baoqt/Bluetooth_IMU/PCB files/CAMOutputs_2_0/BOM.xls

10sets |  | PCBWay Comments | Your Reply | Item # | Designator | QTY | Manufacturer | MFG Part # | Description / Value | Package / Footprint | Type |  |  |  | Instructions / Notes
$0.420 | $8.40 | updated EVQ-Q2B03W |  | 1 | B1, B2 | 2 | C&K | EVQ-Q2B03W |  |  | SMT
$0.105 | $1.05 |  |  | 2 | C1 | 1 | Murata Electronics | GRM188R71C474MA88D | 0.47u | C0402 | SMT
$0.053 | $1.58 |  |  | 3 | C2, C5, C6 | 3 | Samsung Electro-Mechanics | CL05B104KO5NNNC | 0.1u | C0402 | SMT
$0.420 | $4.20 | 7-10work days |  | 4 | C3 | 1 | Taiyo Yuden | HMK105B7103KVHFE | 10n | C0402 | SMT
$0.210 | $2.10 |  |  | 5 | C4 | 1 | Samsung Electro-Mechanics | CL31B225KBHNNNE | 2.2n | C1206 | SMT
$0.105 | $4.20 |  |  | 6 | C7, C8, C9, C10 | 4 | Samsung Electro-Mechanics | CL21A475KAQNNNE | 4.7u | C0805 | SMT
$0.105 | $4.20 |  |  | 7 | C11, C12, C14, C15 | 4 | Samsung Electro-Mechanics | CL05A105KA5NQNC | 1u | C0402 | SMT
$0.840 | $8.40 | updated digikey2500pcs 7-10work days |  | 8 | C13 | 1 | Vishay | 593D107X9010C2TE3 | 100u | C2312 | SMT
$0.105 | $1.05 |  |  | 9 | LED1 | 1 | Lite-On Inc. | LTST-C190KRKT | Red | SML0603 | SMT
$0.105 | $1.05 | LTST-C190KGKT |  | 10 | LED2 | 1 | Lite-On Inc. | LTST-C190KGKT | Green | SML0603 | SMT
$0.105 | $1.05 | LTST-C190TBKT |  | 11 | LED3 | 1 | Lite-On Inc. | LTST-C190TBKT | Blue | SML0603 | SMT
$0.032 | $0.63 |  |  | 12 | R1, R2 | 2 | Panasonic Electronic Components | ERJ-3EKF5111V | 5.11k | R0603 | SMT
$0.032 | $0.63 | no stock, suggest RC0603FR-071KL | Substitution acceptable | 13 | R3, R4 | 2 | Vishay | MCT0603MD1001DP500 | 1k | R0603 | SMT
$0.032 | $0.32 |  |  | 14 | R5 | 1 | Vishay | CRCW060322K1FKEA | 22.1k | R0603 | SMT
$0.032 | $0.32 |  |  | 15 | R6 | 1 | Vishay | CRCW040247K5FKED | 47.5k | R0402 | SMT
$0.032 | $0.32 |  |  | 16 | R7 | 1 | Vishay | CRCW0402100RFKTD | 100 | R0402 | SMT
$0.032 | $1.26 |  |  | 17 | R8, R9, R12, R15 | 4 | Vishay | CRCW040210K0JNEDIF | 10k | R0402 | SMT
$0.032 | $0.32 |  |  | 18 | R10 | 1 | Vishay | CRCW040275K0JNED | 75k | R0402 | SMT
$0.472 | $14.18 | 7-10work days |  | 19 | R16, R19, R20 | 3 | Vishay | MCT0603MC1003FP500 | 100k | R0603 | SMT
$0.032 | $0.95 |  |  | 20 | R11, R13, R14 | 3 | Vishay | CRCW0402470RJNED | 470 | R0402 | SMT
$0.105 | $1.05 | no stock, suggest RC1206FR-074M99L 4.99M please confirm | Substitution acceptable | 21 | R17 | 1 | Susumu | RG3216P-5004-B-T1 | 5M | R0805 | SMT
$6.090 | $60.90 |  |  | 23 | U1 | 1 | TDK InvenSense | ICM-20689 |  | 24-QFN(4X4) | SMT | MEMS sensor, shock sensitive
$6.825 | $68.25 |  |  | 24 | U2 | 1 | Espressif Systems | ESP32-WROOM-32D (16MB) |  |  | SMT
$5.250 | $52.50 |  |  | 25 | U3 | 1 | Silicon Labs | CP2102N-A02-GQFN28R |  | 28-QFN(5X5) | SMT
$0.420 | $4.20 | updated mouser 167pcs 7-10work days |  | 26 | U4 | 1 | Rohm Semiconductor | UMH3NFHATN |  | UMT6 | SMT
$0.945 | $9.45 |  |  | 27 | U5 | 1 | Microchip Technology | MCP73831T-2ATI/OT |  | SOT-23-5 | SMT
$0.840 | $8.40 | updated in stock |  | 28 | U6 | 1 | Diodes Incorporated | AP7331-SNG-7 |  | U-DFN2020-6 | SMT
$0.945 | $9.45 |  |  | 29 | U7 | 1 | JST Sales America Inc. | S2B-PH-SM4-TB(LF)(SN) |  | S2B-PH-SM4-TB(LF)(SN) | SMT
$0.630 | $6.30 |  |  | 30 | U8 | 1 | Littelfuse Inc. | SP0503BAHTG |  | SOT-143-4 | SMT
$1.260 | $12.60 | 7-10work days |  | 31 | U9 | 1 | Molex | 2137160001 |  |  | THT
$0.420 | $4.20 | TC7WZ00FK,LJ(CT 7-10work days, pad design is larger than component，please provide with correct part number | Pad updated in new gerber files. | 32 | U10 | 1 | Toshiba Semiconductor and Storage | TC7WZ00FK |  | US8_TOS | SMT
 | $293.475 |  |  |  | Total Components | 49
quote to MFG Part #
 |  |  | Digikey Part Number | Type | Value | SMT | Cost |  | Signifier | Manufacturer Part Number | Digikey Part Number | Type | Value | SMT
 |  |  | P12932SCT-ND | Button |  | Yes | 0.28 |  | B1 | EVQ-Q2B03W | P12932SCT-ND | Button |  | Yes
 |  |  | 490-GRM188R71C474MA88DDKR-ND | Capacitor | 0.47u | Yes | 0.15 |  | B2 | EVQ-Q2B03W | P12932SCT-ND | Button |  | Yes
 |  |  | 1276-1001-1-ND | Capacitor | 0.1u | Yes | 0.10 |  | C1 | GRM188R71C474MA88D | 490-GRM188R71C474MA88DDKR-ND | Capacitor | 0.47u | Yes
 |  |  | 587-HMK105B7103KVHFECT-ND | Capacitor | 10n | Yes | 0.20 |  | C2 | CL05B104KO5NNNC | 1276-1001-1-ND | Capacitor | 0.1u | Yes
 |  |  | 1276-1291-1-ND | Capacitor | 2.2n | Yes | 0.26 |  | C3 | HMK105B7103KVHFE | 587-HMK105B7103KVHFECT-ND | Capacitor | 10n | Yes
 |  |  | 1276-1244-1-ND | Capacitor | 4.7u | Yes | 0.11 |  | C4 | CL31B225KBHNNNE | 1276-1291-1-ND | Capacitor | 2.2n | Yes
 |  |  | 1276-1445-1-ND | Capacitor | 1u | Yes | 0.20 |  | C5 | CL05B104KO5NNNC | 1276-1001-1-ND | Capacitor | 0.1u | Yes
 |  |  | 718-1971-6-ND | Capacitor | 100u | Yes | 0.80 |  | C6 | CL05B104KO5NNNC | 1276-1001-1-ND | Capacitor | 0.1u | Yes
 |  |  | 160-1436-1-ND | LED | Red | Yes | 0.25 |  | C7 | CL21A475KAQNNNE | 1276-1244-1-ND | Capacitor | 4.7u | Yes
 |  |  | 160-1435-1-ND | LED | Green | Yes | 0.31 |  | C8 | CL21A475KAQNNNE | 1276-1244-1-ND | Capacitor | 4.7u | Yes
 |  |  | 160-1646-1-ND | LED | Blue | Yes | 0.26 |  | C9 | CL21A475KAQNNNE | 1276-1244-1-ND | Capacitor | 4.7u | Yes
 |  |  | P5.11KHCT-ND | Resistor | 5.11k | Yes | 0.10 |  | C10 | CL21A475KAQNNNE | 1276-1244-1-ND | Capacitor | 4.7u | Yes
 |  |  | MCT0603-1.0K-MDDKR-ND | Resistor | 1k | Yes | 0.36 |  | C11 | CL05A105KA5NQNC | 1276-1445-1-ND | Capacitor | 1u | Yes
 |  |  | 541-22.1KHDKR-ND | Resistor | 22.1k | Yes | 0.10 |  | C12 | CL05A105KA5NQNC | 1276-1445-1-ND | Capacitor | 1u | Yes
 |  |  | 541-47.5KLCT-ND | Resistor | 47.5k | Yes | 0.10 |  | C13 | 593D107X9010C2TE3 | 718-1971-6-ND | Capacitor | 100u | Yes
 |  |  | 541-CRCW0402100RFKTDDKR-ND | Resistor | 100 | Yes | 0.13 |  | C14 | CL05A105KA5NQNC | 1276-1445-1-ND | Capacitor | 1u | Yes
 |  |  | 541-10KATDKR-ND | Resistor | 10k | Yes | 0.40 |  | C15 | CL05A105KA5NQNC | 1276-1445-1-ND | Capacitor | 1u | Yes
 |  |  | 541-75KJDKR-ND | Resistor | 75k | Yes | 0.10 |  | LED1 | LTST-C190KRKT | 160-1436-1-ND | LED | Red | Yes
 |  |  | MCT0603-100K-MFCT-ND | Resistor | 100k | Yes | 0.31 |  | LED2 | LTST-C190KGKT | 160-1435-1-ND | LED | Green | Yes
 |  |  | 541-470JDKR-ND | Resistor | 470 | Yes | 0.10 |  | LED3 | LTST-C190TBKT | 160-1646-1-ND | LED | Blue | Yes
 |  |  | 408-2038-1-ND | Resistor | 5M | Yes | 1.96 |  | R1 | ERJ-3EKF5111V | P5.11KHCT-ND | Resistor | 5.11k | Yes
 |  |  | 1428-1059-1-ND | IC |  | Yes | 6.36 |  | R2 | ERJ-3EKF5111V | P5.11KHCT-ND | Resistor | 5.11k | Yes
 |  |  | 1904-1025-6-ND | Module |  | Yes | 4.50 |  | R3 | MCT0603MD1001DP500 | MCT0603-1.0K-MDDKR-ND | Resistor | 1k | Yes
 |  |  | 336-5890-1-ND | IC |  | Yes | 1.40 |  | R4 | MCT0603MD1001DP500 | MCT0603-1.0K-MDDKR-ND | Resistor | 1k | Yes
 |  |  | UMH3NFHATNCT-ND | IC |  | Yes | 0.38 |  | R5 | CRCW060322K1FKEA | 541-22.1KHDKR-ND | Resistor | 22.1k | Yes
 |  |  | MCP73831T-2ATI/OTCT-ND | IC |  | Yes | 0.59 |  | R6 | CRCW040247K5FKED | 541-47.5KLCT-ND | Resistor | 47.5k | Yes
 |  |  | AP7331-SNG-7DICT-ND | IC |  | Yes | 0.46 |  | R7 | CRCW0402100RFKTD | 541-CRCW0402100RFKTDDKR-ND | Resistor | 100 | Yes
 |  |  | 455-1749-1-ND | Connector |  | Yes | 0.53 |  | R8 | CRCW040210K0JNEDIF | 541-10KATDKR-ND | Resistor | 10k | Yes
 |  |  | F2715DKR-ND | IC |  | Yes | 0.89 |  | R9 | CRCW040210K0JNEDIF | 541-10KATDKR-ND | Resistor | 10k | Yes
 |  |  | 900-2137160001CT-ND | Connector |  | No | 1.12 |  | R10 | CRCW040275K0JNED | 541-75KJDKR-ND | Resistor | 75k | Yes
 |  |  | TC7WZ00FKLJ(CTCT-ND | IC |  | Yes | 0.40 |  | R11 | CRCW0402470RJNED | 541-470JDKR-ND | Resistor | 470 | Yes
 |  |  |  |  |  |  | #REF! |  | R12 | CRCW040210K0JNEDIF | 541-10KATDKR-ND | Resistor | 10k | Yes
 |  |  |  |  |  |  |  |  | R13 | CRCW0402470RJNED | 541-470JDKR-ND | Resistor | 470 | Yes
 |  |  |  |  |  |  |  |  | R14 | CRCW0402470RJNED | 541-470JDKR-ND | Resistor | 470 | Yes
 |  |  |  |  |  |  |  |  | R15 | CRCW040210K0JNEDIF | 541-10KATDKR-ND | Resistor | 10k | Yes
 |  |  |  |  |  |  |  |  | R16 | MCT0603MC1003FP500 | MCT0603-100K-MFCT-ND | Resistor | 100k | Yes
 |  |  |  |  |  |  |  |  | R17 | HVC0805T5004JET | HVC0805T5004JETCT-ND | Resistor | 5M | Yes
 |  |  |  |  |  |  |  |  | R19 | MCT0603MC1003FP500 | MCT0603-100K-MFCT-ND | Resistor | 100k | Yes
 |  |  |  |  |  |  |  |  | R20 | MCT0603MC1003FP500 | MCT0603-100K-MFCT-ND | Resistor | 100k | Yes
 |  |  |  |  |  |  |  |  | U1 | ICM-20689 | 1428-1059-1-ND | IC |  | Yes
 |  |  |  |  |  |  |  |  | U2 | ESP32-WROOM-32D (16MB) | 1904-1025-6-ND | Module |  | Yes
 |  |  |  |  |  |  |  |  | U3 | CP2102N-A02-GQFN28R | 336-5890-1-ND | IC |  | Yes
 |  |  |  |  |  |  |  |  | U4 | UMH3NFHATN | UMH3NFHATNCT-ND | IC |  | Yes
 |  |  |  |  |  |  |  |  | U5 | MCP73831T-2ATI/OT | MCP73831T-2ATI/OTCT-ND | IC |  | Yes
 |  |  |  |  |  |  |  |  | U6 | AP7331-SNG-7 | AP7331-SNG-7DICT-ND | IC |  | Yes
 |  |  |  |  |  |  |  |  | U7 | S2B-PH-SM4-TB(LF)(SN) | 455-1749-1-ND | Connector |  | Yes
 |  |  |  |  |  |  |  |  | U8 | SP0503BAHTG | F2715DKR-ND | IC |  | Yes
 |  |  |  |  |  |  |  |  | U9 | 2137160001 | 900-2137160001CT-ND | Connector |  | No
 |  |  |  |  |  |  |  |  | U10 | TC7WZ00FK | TC7WZ00FKLJ(CTCT-ND | IC |  | Yes
