baoqt/Bluetooth_IMU/PCB files/BT_IMU_2_0.brd

## EAGLE design PCB files/BT_IMU_2_0.brd (2021-10-09)

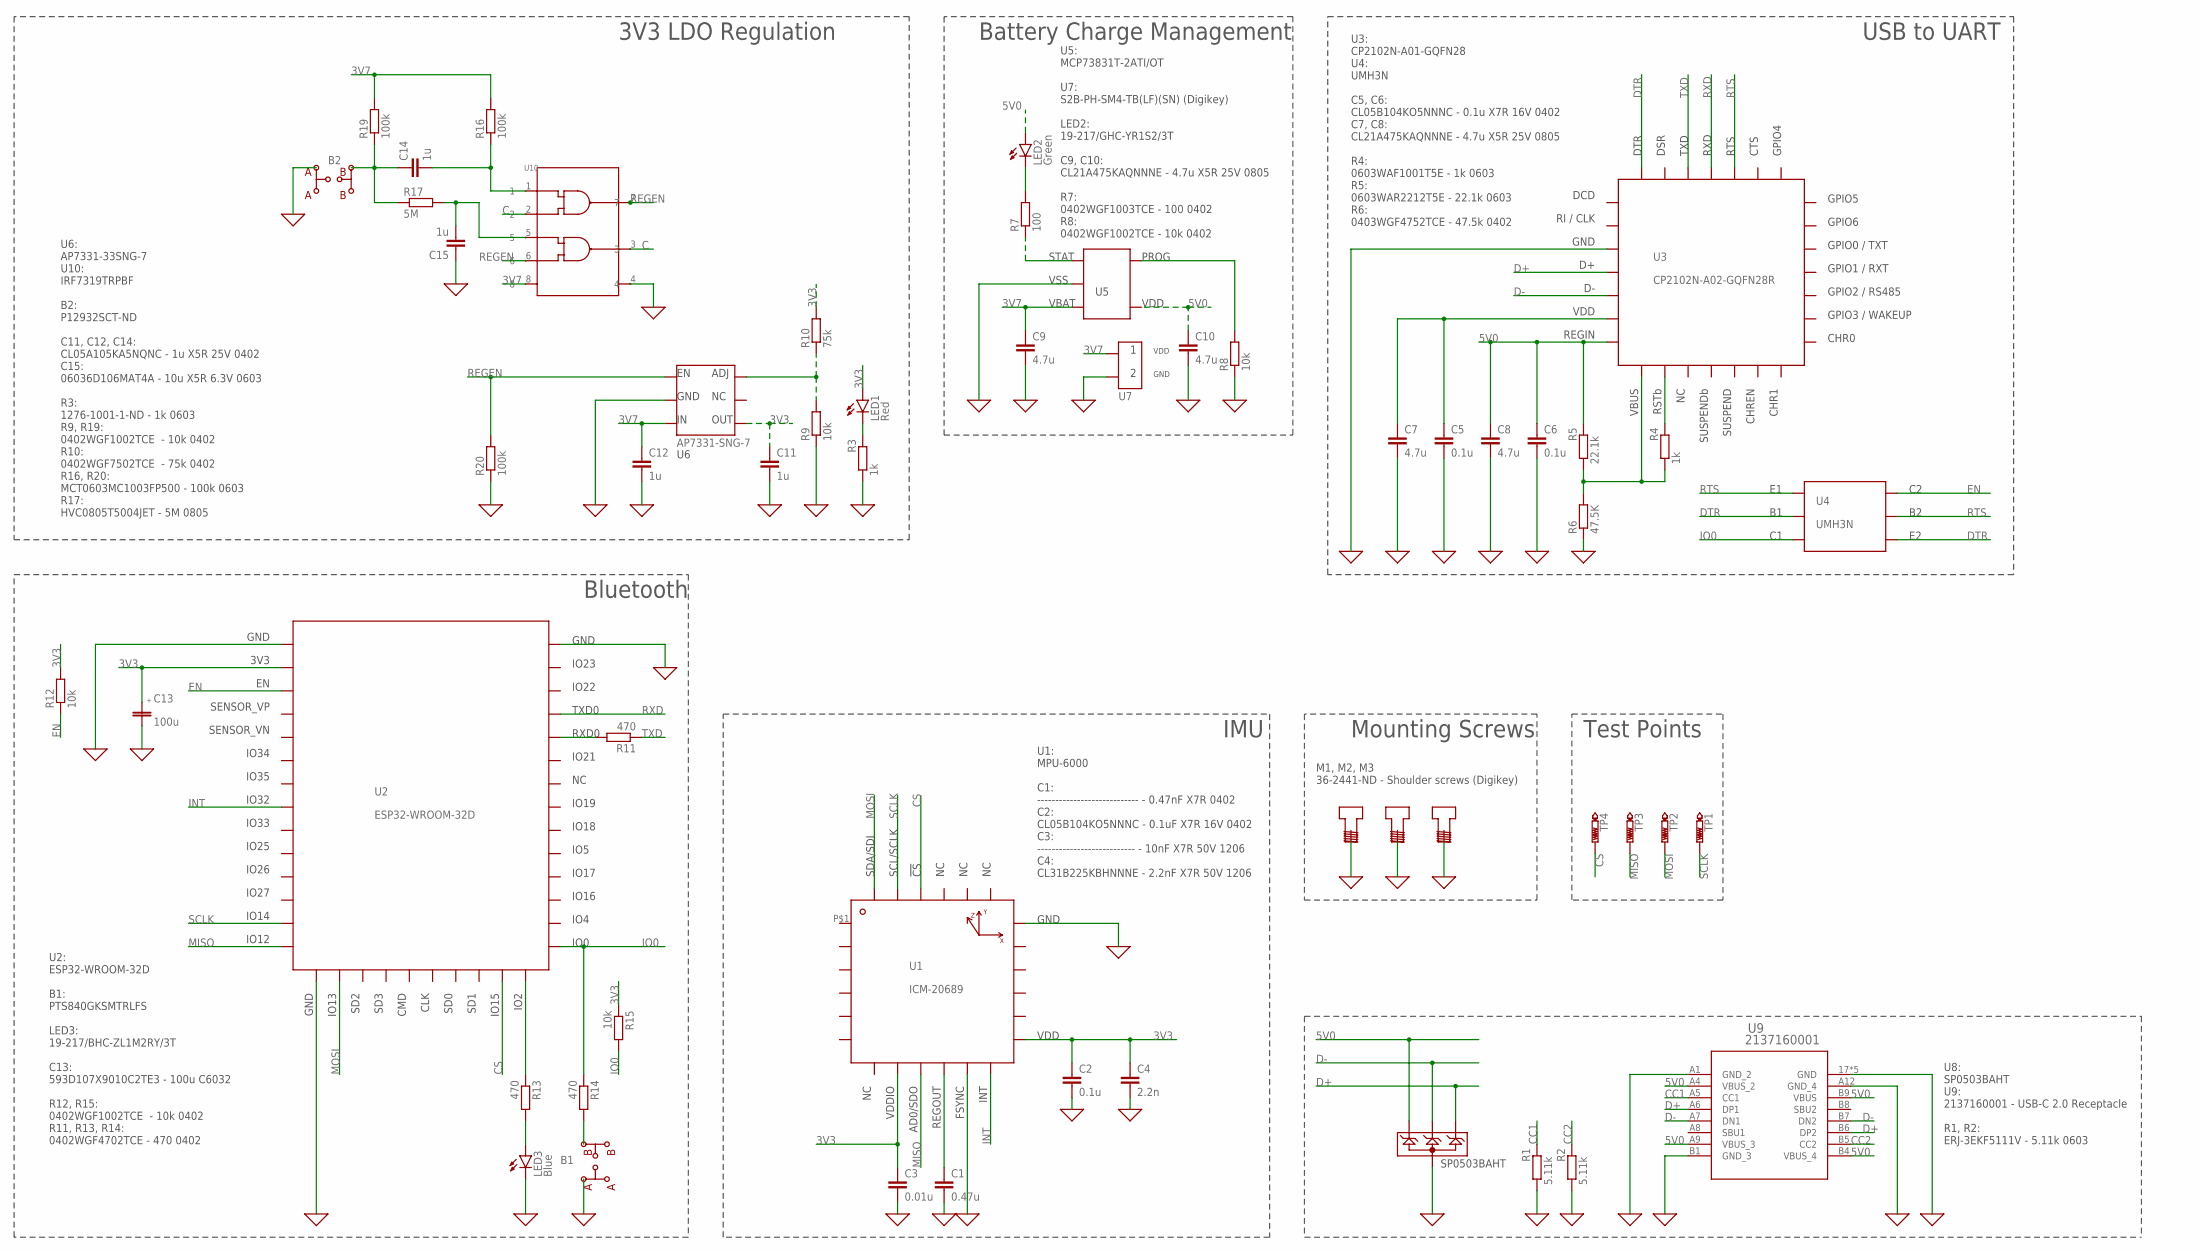
[picture p1: schematic BT_IMU_2_0.sch]

Parts:
B1, B2: P12932SCT-ND
C1: 0.47u; C0603
C2, C5, C6: 0.1u; C0402
C3: 0.01u; C0402
C4: 2.2n; C1206
C7, C8, C9, C10: 4.7u; C0805
C11, C12, C14: 1u; C0402
C13: 100u; C6032
C15: 1u; C0603
LED1: Red; CHIP-LED0603
LED2: Green; SML0603
LED3: Blue; SML0603
M1, M2, M3: 2441
R1, R2: 5.11k; R0603
R3, R4: 1k; R0603
R5: 22.1k; R0603
R6: 47.5K; R0402
R7: 100; R0402
R8, R9, R12, R15: 10k; R0402
R10: 75k; R0402
R11, R13, R14: 470; R0402
R16, R19, R20: 100k; R0603
R17: 5M; R0805
TP1, TP2, TP3, TP4: PTR1B1,27; B1,27
U1: ICM-20689; 24-QFN(4X4)
U2: ESP32-WROOM-32D
U3: CP2102N-A02-GQFN28R; 28-QFN(5X5)
U4: UMH3N; UMT6
U5: MCP73831T-2ATI/OT; SOT-23-5
U6: AP7331-SNG-7; U-DFN2020-6
U7: S2B-PH-SM4-TB(LF)(SN)
U8: SP0503BAHT; SOT-143-4
U9: 2137160001; 2137160001_MOL
U10: TC7WZ00FKSOT-765; SOT-765

Connections:
0: B1.P$2, B2.P$2, C1.2, C2.2, C3.2, C4.2, C5.2, C6.2, C7.2, C8.2, C9.2, C10.2, C11.2, C12.2, C13.P$2, C15.1, LED3.C, M1.P$1, M2.P$1, M3.P$1, R1.1, R2.1, R3.1, R6.1, R8.1, R9.1, R20.1, U1.P$11, U1.P$18, U2.P$1, U2.P$15, U2.P$38, U2.P$39, U2.P$40, U2.P$41, U2.P$42, U2.P$43, U2.P$44, U2.P$45, U2.P$46, U2.P$47, U3.P$2, U3.P$28, U3.P$29, U3.P$30, U3.P$31, U3.P$32, U3.P$33, U3.P$34, U3.P$35, U3.P$36, U5.P$2, U6.P$2, U6.P$7, U6.P$8, U7.P$2, U8.P$1, U9.17 (GND), U9.18 (GND), U9.19 (GND), U9.20 (GND), U9.A1 (GND_2), U9.A12 (GND_4), U9.B1 (GND_3), U9.B12 (GND), U10.4
3V3: C2.1, C3.1, C4.1, C11.1, C13.P$1, LED1.A, R10.2, R12.2, R15.1, U1.P$8, U1.P$13, U2.P$2, U6.P$4
3V7: C9.1, C12.1, R16.2, R19.2, U5.P$3, U6.P$3, U7.P$1, U10.8
5V0: C6.1, C8.1, C10.1, LED2.A, R5.2, U3.P$6, U5.P$4, U8.P$2, U9.A4 (VBUS_2), U9.A9 (VBUS_3), U9.B4 (VBUS_4), U9.B9 (VBUS)
C: U10.2, U10.3
CC1: R1.2, U9.A5 (CC1)
CC2: R2.2, U9.B5 (CC2)
CS: TP4.TP, U1.P$22, U2.P$23
D+: U3.P$3, U8.P$4, U9.A6 (DP1), U9.B6 (DP2)
D-: U3.P$4, U8.P$3, U9.A7 (DN1), U9.B7 (DN2)
DTR: U3.P$27, U4.P$2, U4.P$4
EN: R12.1, U2.P$3, U4.P$6
INT: U1.P$12, U2.P$8
IO0: R14.1, R15.2, U2.P$25, U4.P$3
MISO: TP3.TP, U1.P$9, U2.P$14
MOSI: TP2.TP, U1.P$24, U2.P$16
unnamed: C1.1, U1.P$10
unnamed: B1.P$4, R14.2
unnamed: LED1.C, R3.2
unnamed: R4.2, U3.P$8
unnamed: R4.1, R5.1, R6.2, U3.P$7
unnamed: C5.1, C7.1, U3.P$5
unnamed: R7.1, U5.P$1
unnamed: R11.2, U2.P$34
unnamed: R8.2, U5.P$5
unnamed: LED2.C, R7.2
unnamed: R9.2, R10.1, U6.P$6
unnamed: R13.1, U2.P$24
unnamed: C15.2, R17.2, U10.5
unnamed: B2.P$4, C14.1, R17.1, R19.1
unnamed: LED3.A, R13.2
unnamed: C14.2, R16.1, U10.1
REGEN: R20.2, U6.P$1, U10.6, U10.7
RTS: U3.P$23, U4.P$1, U4.P$5
RXD: U2.P$35, U3.P$24
SCLK: TP1.TP, U1.P$23, U2.P$13
TXD: R11.1, U3.P$25

Notes on the sheet:
U1: MPU-6000 C1: ---------------------------- - 0.47nF X7R 0402 C2: CL05B104KO5NNNC - 0.1uF X7R 16V 0402 C3: --------------------------- - 10nF X7R 50V 1206 C4: CL31B225KBHNNNE - 2.2nF X7R 50V 1206
U3: CP2102N-A01-GQFN28 U4: UMH3N C5, C6: CL05B104KO5NNNC - 0.1u X7R 16V 0402 C7, C8: CL21A475KAQNNNE - 4.7u X5R 25V 0805 R4: 0603WAF1001T5E - 1k 0603 R5: 0603WAR2212T5E - 22.1k 0603 R6: 0403WGF4752TCE - 47.5k 0402
USB to UART
IMU
M1, M2, M3 36-2441-ND - Shoulder screws (Digikey)
U5: MCP73831T-2ATI/OT U7: S2B-PH-SM4-TB(LF)(SN) (Digikey) LED2: 19-217/GHC-YR1S2/3T C9, C10: CL21A475KAQNNNE - 4.7u X5R 25V 0805 R7: 0402WGF1003TCE - 100 0402 R8: 0402WGF1002TCE - 10k 0402
U6: AP7331-33SNG-7 U10: IRF7319TRPBF B2: P12932SCT-ND C11, C12, C14: CL05A105KA5NQNC - 1u X5R 25V 0402 C15: 06036D106MAT4A - 10u X5R 6.3V 0603 R3: 1276-1001-1-ND - 1k 0603 R9, R19: 0402WGF1002TCE - 10k 0402 R10: 0402WGF7502TCE - 75k 0402 R16, R20: MCT0603MC1003FP500 - 100k 0603 R17: HVC0805T5004JET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
Battery Charge Management
Mounting Screws
3V3 LDO Regulation
Bluetooth
U2: ESP32-WROOM-32D B1: PTS840GKSMTRLFS LED3: 19-217/BHC-ZL1M2RY/3T C13: 593D107X9010C2TE3 - 100u C6032 R12, R15: 0402WGF1002TCE - 10k 0402 R11, R13, R14: 0402WGF4702TCE - 470 0402
Test Points
U8: SP0503BAHT U9: 2137160001 - USB-C 2.0 Receptacle R1, R2: ERJ-3EKF5111V - 5.11k 0603

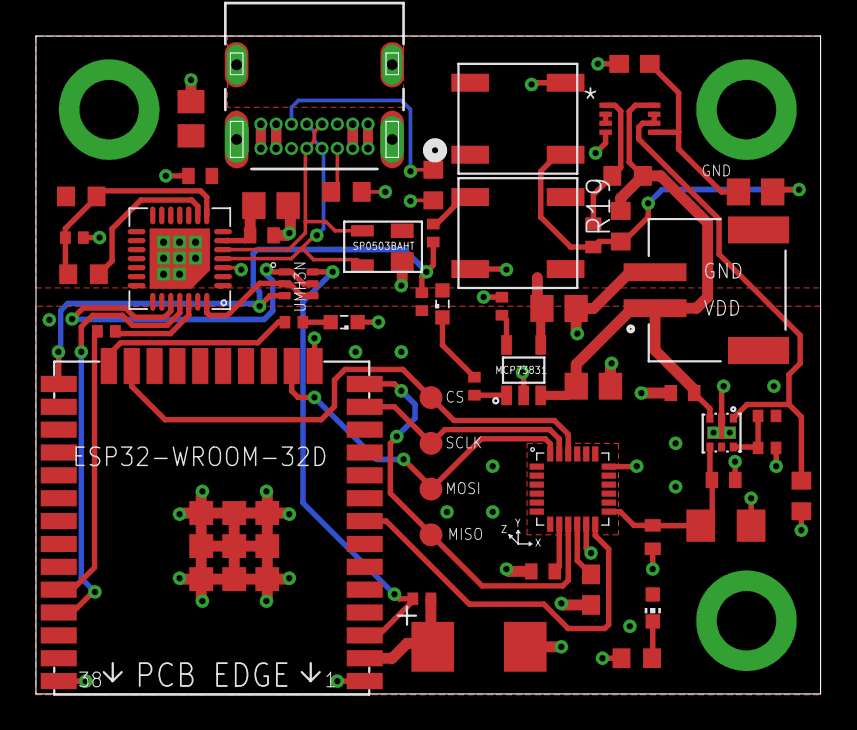
[picture p2: board BT_IMU_2_0.brd from above]

Board: 4 copper layers, 43.6 x 36.5 mm, 58 parts (0 on the bottom side), 37 nets.

Other parts of the board:
U$1: SIGNATURE
U$2: TENA_LOGO
