baoqt/Bluetooth_IMU/(commit log)

2021-01-06 Recreated project on newer esp-idf version. Made changes to the FIFO, now works correctly.
    [I2C.c, I2C.h, ICM20948.c, ICM20948.h, main.c, main.h]
2021-01-17 Adjusted output multipliers. Accelerometer output now in m/s^2 instead of Gs.
2021-02-13 Modified polling rate and noise bandwidth of accelerometer.
    [ICM20948.c, ICM20948.h, main.c, main.h]
2021-05-31 Added sensor's internal FIFO functionality. Reduced Bluetooth forwarding frequency from 10Hz to 3Hz.
2021-10-09 Added PCB files folder containing EAGLE project files.
    [BOM.xls, BT_IMU_2_0.brd, BT_IMU_2_0.sch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]
2021-10-16 Fix issue with scaling.
    [ICM20689.c, main.c, main.h]
2022-02-19 Update to filtering.
2022-04-25 Removed calibration step
