baoqt/Bluetooth_IMU/(notices)

Notices in the files:
parts and their libraries:
COPYRIGHT: Copyright (C) 2018 Accelerated Designs. All rights reserved
Toshiba: COPYRIGHT: Copyright (C) 2021 Ultra Librarian. All rights reserved.
